kpreid/3dp-tape-cassette-case/(commit log)

2019-06-22 Basic shape.
    [microcassette-case.scad]
2019-06-22 Position for hinge.
    [microcassette-case.scad]
2019-06-22 Temporarily remove chamfers; add end plates.
    [microcassette-case.scad]
2019-06-22 Design hinge
    [microcassette-case.scad]
2019-06-22 Latch nub.
    [microcassette-case.scad]
2019-06-22 Lay out for printing.
    [microcassette-case.scad]
2019-06-22 Chamfer outside.
    [microcassette-case.scad]
2019-06-22 Reel locking pins.
    [microcassette-case.scad]
2019-06-22 Design revisions for second print.
    [microcassette-case.scad]
2019-06-22 Revisions for third print:
    * Put the latch closer to the edge for more flex.
    * Make the latch nub slightly thinner.
    * Overall slightly thicker, for a more reliably easy fit and possible J-card.
    [microcassette-case.scad]
2019-06-23 Move hinge closer to end.
    With the previous design, the pocket edge would collide with the cover diagonal cuts when rotated.
    [microcassette-case.scad]
